AG6GR/PANDAv2/doc/Schematic.png

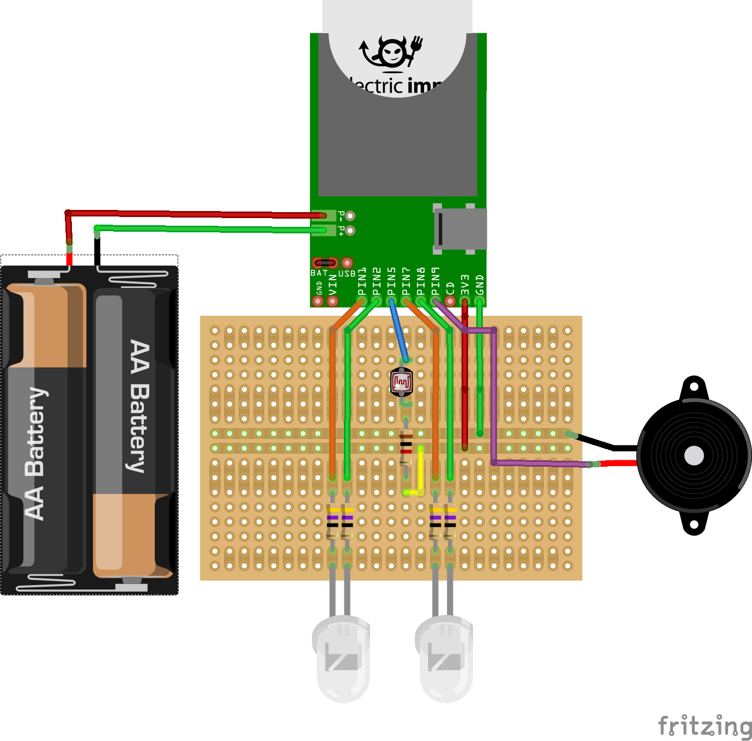
doc/Schematic.png
