AG6GR/PANDAv2/img/PANDAback.png

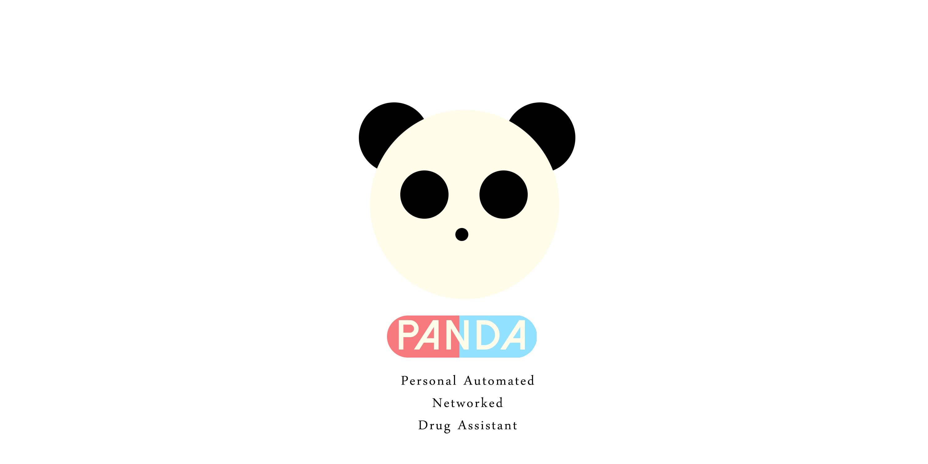
img/PANDAback.png
