AG6GR/PANDAv2/(list of files, drawings)

Other design files:
doc/Schematic.fzz
