AG6GR/PANDAv2/doc/PANDASchematic/PANDASchematic.sch

## EAGLE design doc/PANDASchematic/PANDASchematic.sch (2015-12-10)

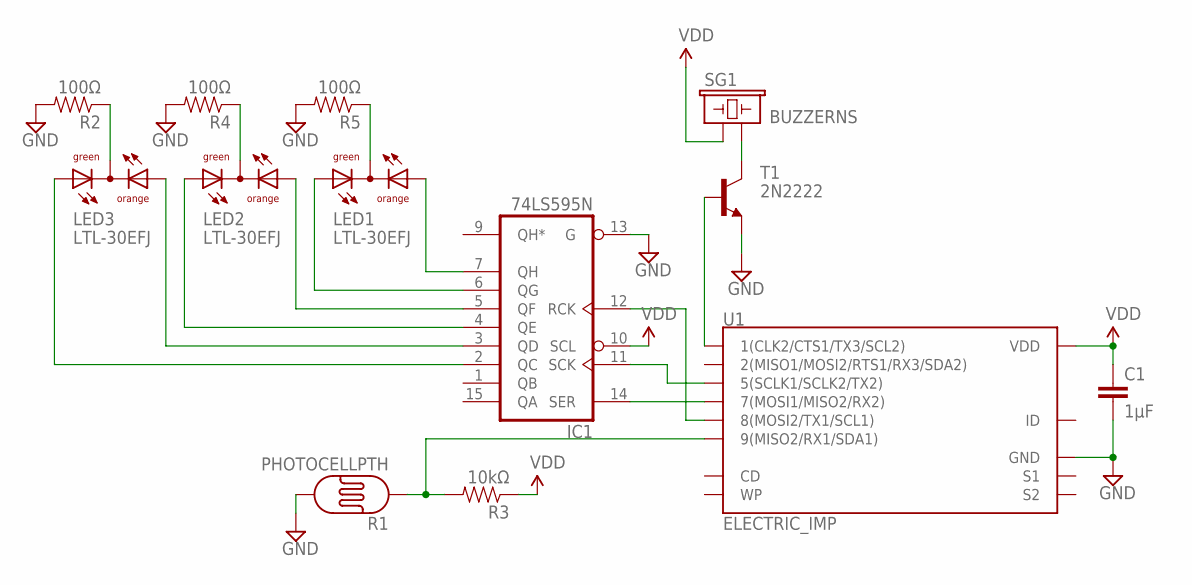
[picture p14: schematic PANDASchematic.sch]

Parts:
C1: 1µF; CAP-PTH-SMALL
IC1: 74LS595N; DIL16
LED1, LED2, LED3: LTL-30EFJ; TLUV5300
R1: PHOTOCELLPTH; PHOTOCELL
R2, R4, R5: 100Ω; AXIAL-0.3
R3: 10kΩ; AXIAL-0.3
SG1: BUZZERNS; BUZZER-12MM-NS
T1: 2N2222; TO92-EBC-OVAL
U1: ELECTRIC_IMP; SD_1:1

Connections:
GND: C1.2, IC1.13 (G), R1.2, R2.P$2 (2), R4.P$2 (2), R5.P$2 (2), T1.E, U1.3 (GND)
unnamed: IC1.14 (SER), U1.7 (7(MOSI1/MISO2/RX2))
unnamed: IC1.11 (SCK), U1.5 (5(SCLK1/SCLK2/TX2))
unnamed: SG1.- (2), T1.C
unnamed: IC1.3 (QD), LED3.AO
unnamed: IC1.12 (RCK), U1.8 (8(MOSI2/TX1/SCL1))
unnamed: R1.1, R3.P$2 (2), U1.9 (9(MISO2/RX1/SDA1))
unnamed: IC1.2 (QC), LED3.AG
unnamed: LED3.CC, R2.P$1 (1)
unnamed: IC1.7 (QH), LED1.AO
unnamed: IC1.6 (QG), LED1.AG
unnamed: IC1.5 (QF), LED2.AO
unnamed: IC1.4 (QE), LED2.AG
unnamed: T1.B, U1.1 (1(CLK2/CTS1/TX3/SCL2))
unnamed: LED2.CC, R4.P$1 (1)
unnamed: LED1.CC, R5.P$1 (1)
VDD: C1.1, IC1.10 (SCL), R3.P$1 (1), SG1.+ (1), U1.4 (VDD)
