AG6GR/PANDAv2/test.html

## Set Up PANDA

### Box 1:

### Prescription

Dose by the hour

Hours between doses

Example: 5

Hours between doses

Example: 30

Start Time

24 hour time Example: 06:00

Dose by time of day

Times for doses

hh:mm Example: 06:00,12:00,18:00

### Box 2:

### Prescription

### Dose by the hour

### Hours between doses

### Example: 5

### Minutes between doses

### Example: 30

### Start Time

### 24 hour time Example: 06:00

### Dose by time of day

### Times of doses

### hh:mm Example: 06:00,12:00,18:00

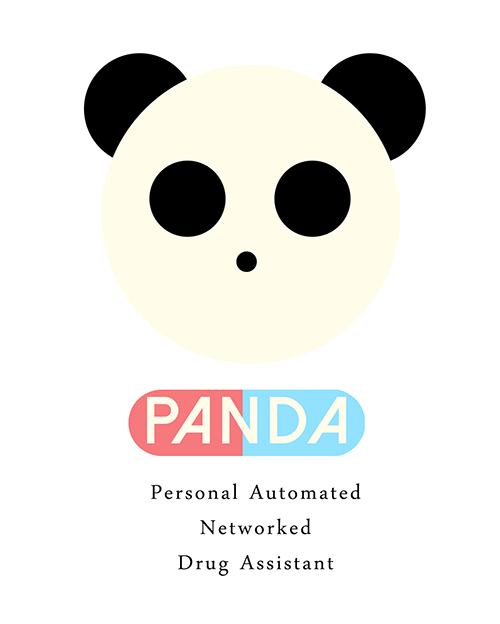
[picture p15: img/PANDAmini.png]
### 

### Submit!
