AG6GR/PANDAv2/(commit log)

2015-12-04 Drew schematic for including LCD
    [PANDASchematic.sch]
2015-12-06 Laid out schematic and state transfers
    [PANDASchematic.sch]
2015-12-06 Updated schematic to match soldered circuit
    [PANDASchematic.sch]
2015-12-08 Updated documentation, added series resistors to SCL/MOSI lines
    [PANDASchematic.sch]
2015-12-10 Updated to 3 LEDs, took only a minute :)
2015-12-10 Updated schematic to 3 LEDs
    [PANDASchematic.sch]
2015-12-11 Added BOM, updating documentation
    [BillOfMaterials.csv]
2015-12-11 Linked to BOM
2015-12-11 Proofreading, updated BOM
